nickerson-b/models/port_2.jpeg

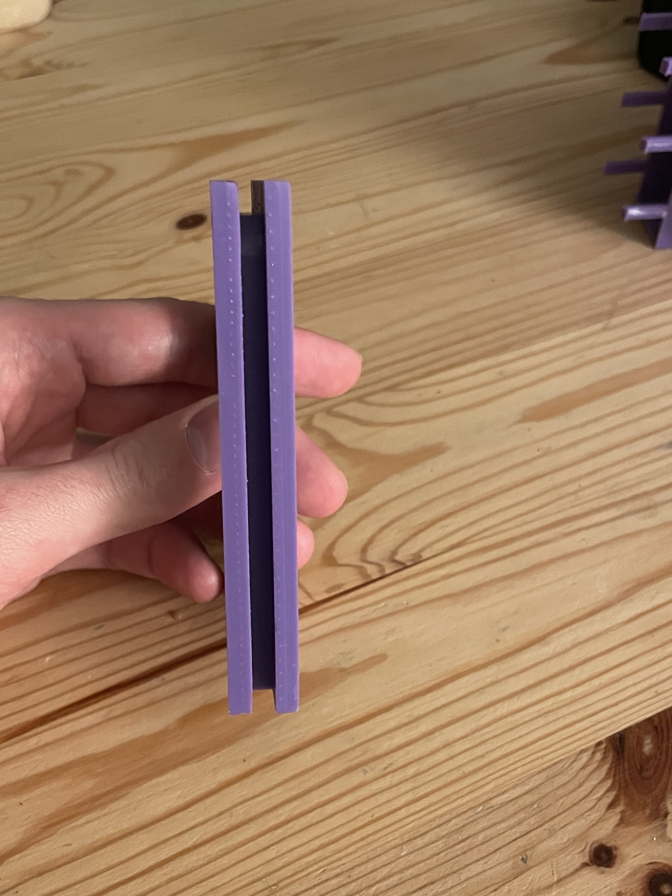
port_2.jpeg
