nickerson-b/models/port_1.jpeg

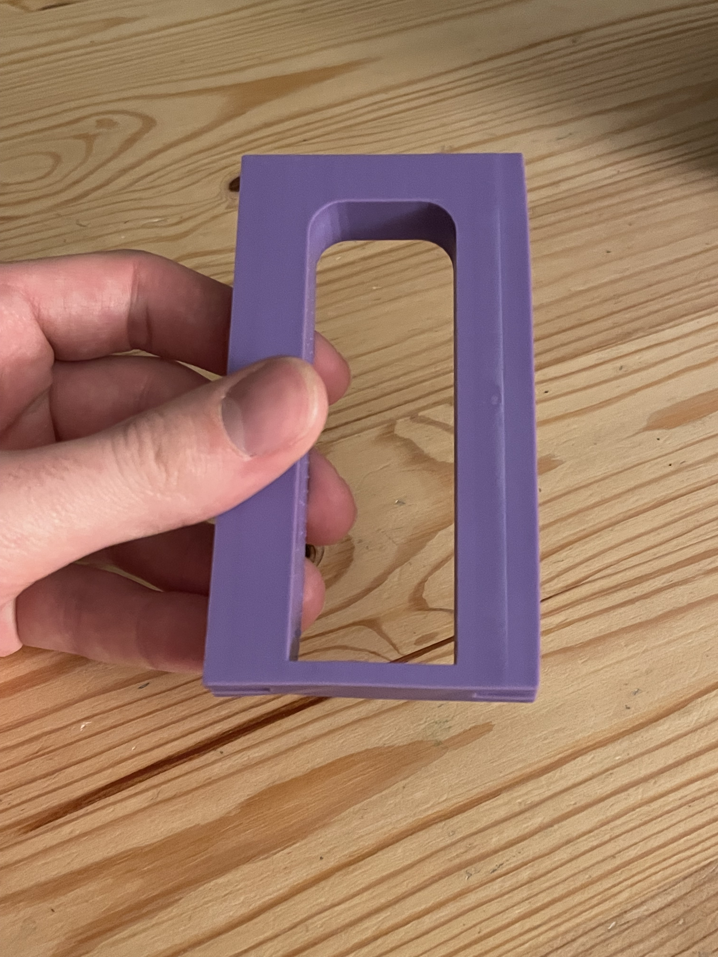
port_1.jpeg
