nickerson-b/models/connected_1.jpeg

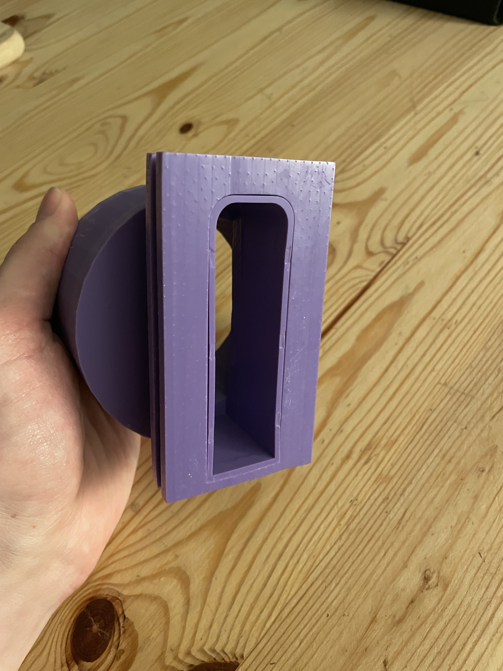
connected_1.jpeg
