nickerson-b/models/connected_2.jpeg

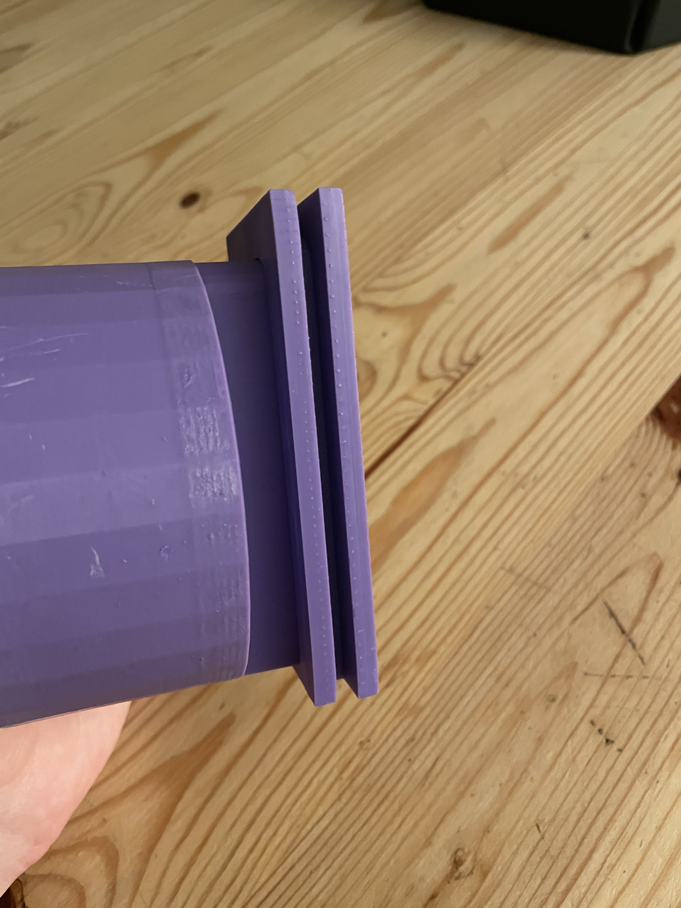
connected_2.jpeg
