nickerson-b/models/insert_1.jpeg

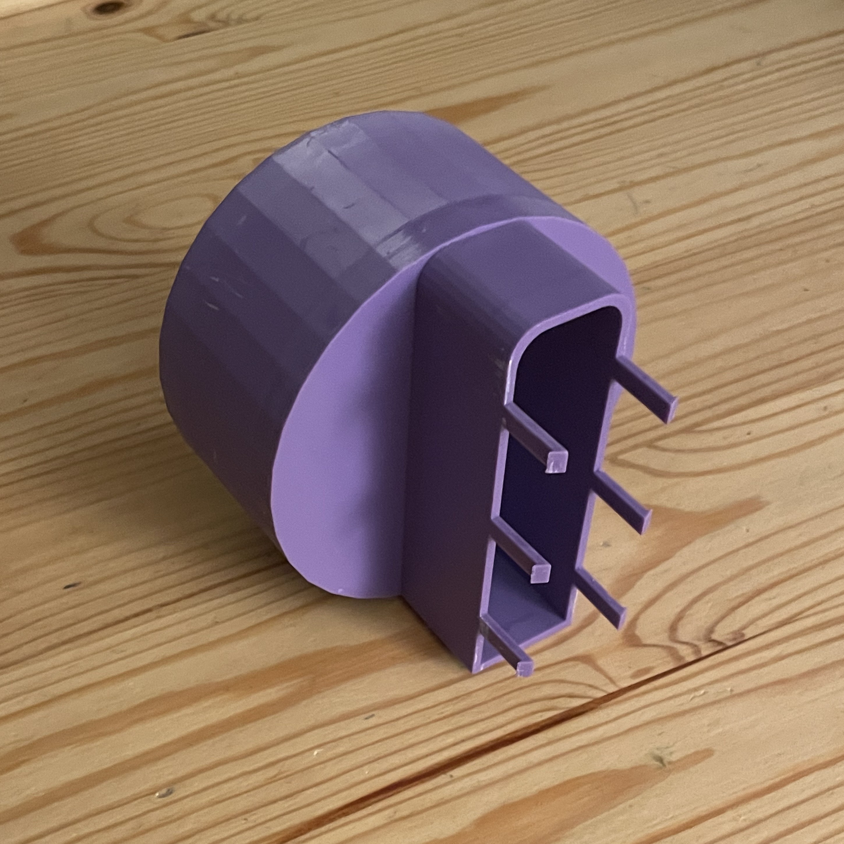
insert_1.jpeg
