nickerson-b/models/insert_2.jpeg

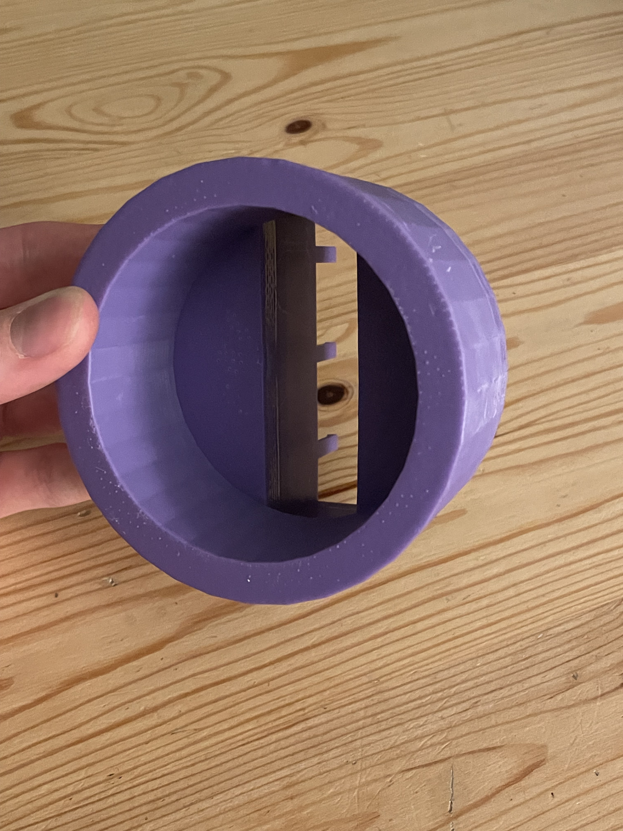
insert_2.jpeg
