nickerson-b/models/port.stl

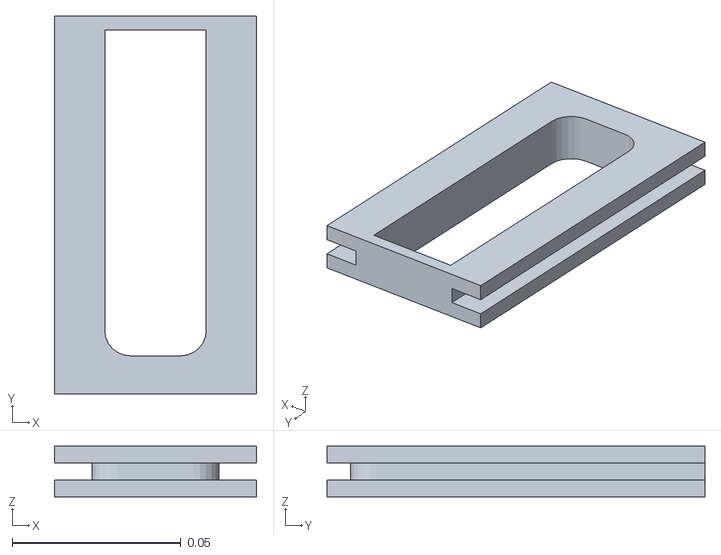
[picture p7: CAD file, 2025-08-15]
port.stl
0.06 x 0.112 x 0.015
