nickerson-b/models/insert.stl

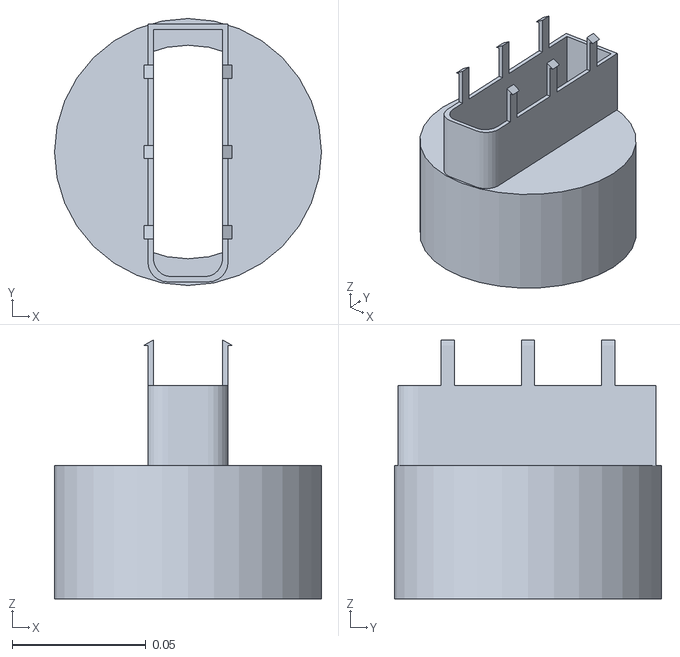
[picture p8: CAD file, 2025-08-15]
insert.stl
0.1 x 0.1 x 0.097
